reversebias/anaphase/README.md

# anaphase wireless split keyboard

anaphase is a Bluetooth/USB split ergonomic keyboard with a 3D printed case and custom PCB base.
