reversebias/anaphase/hardware/schematic.pdf

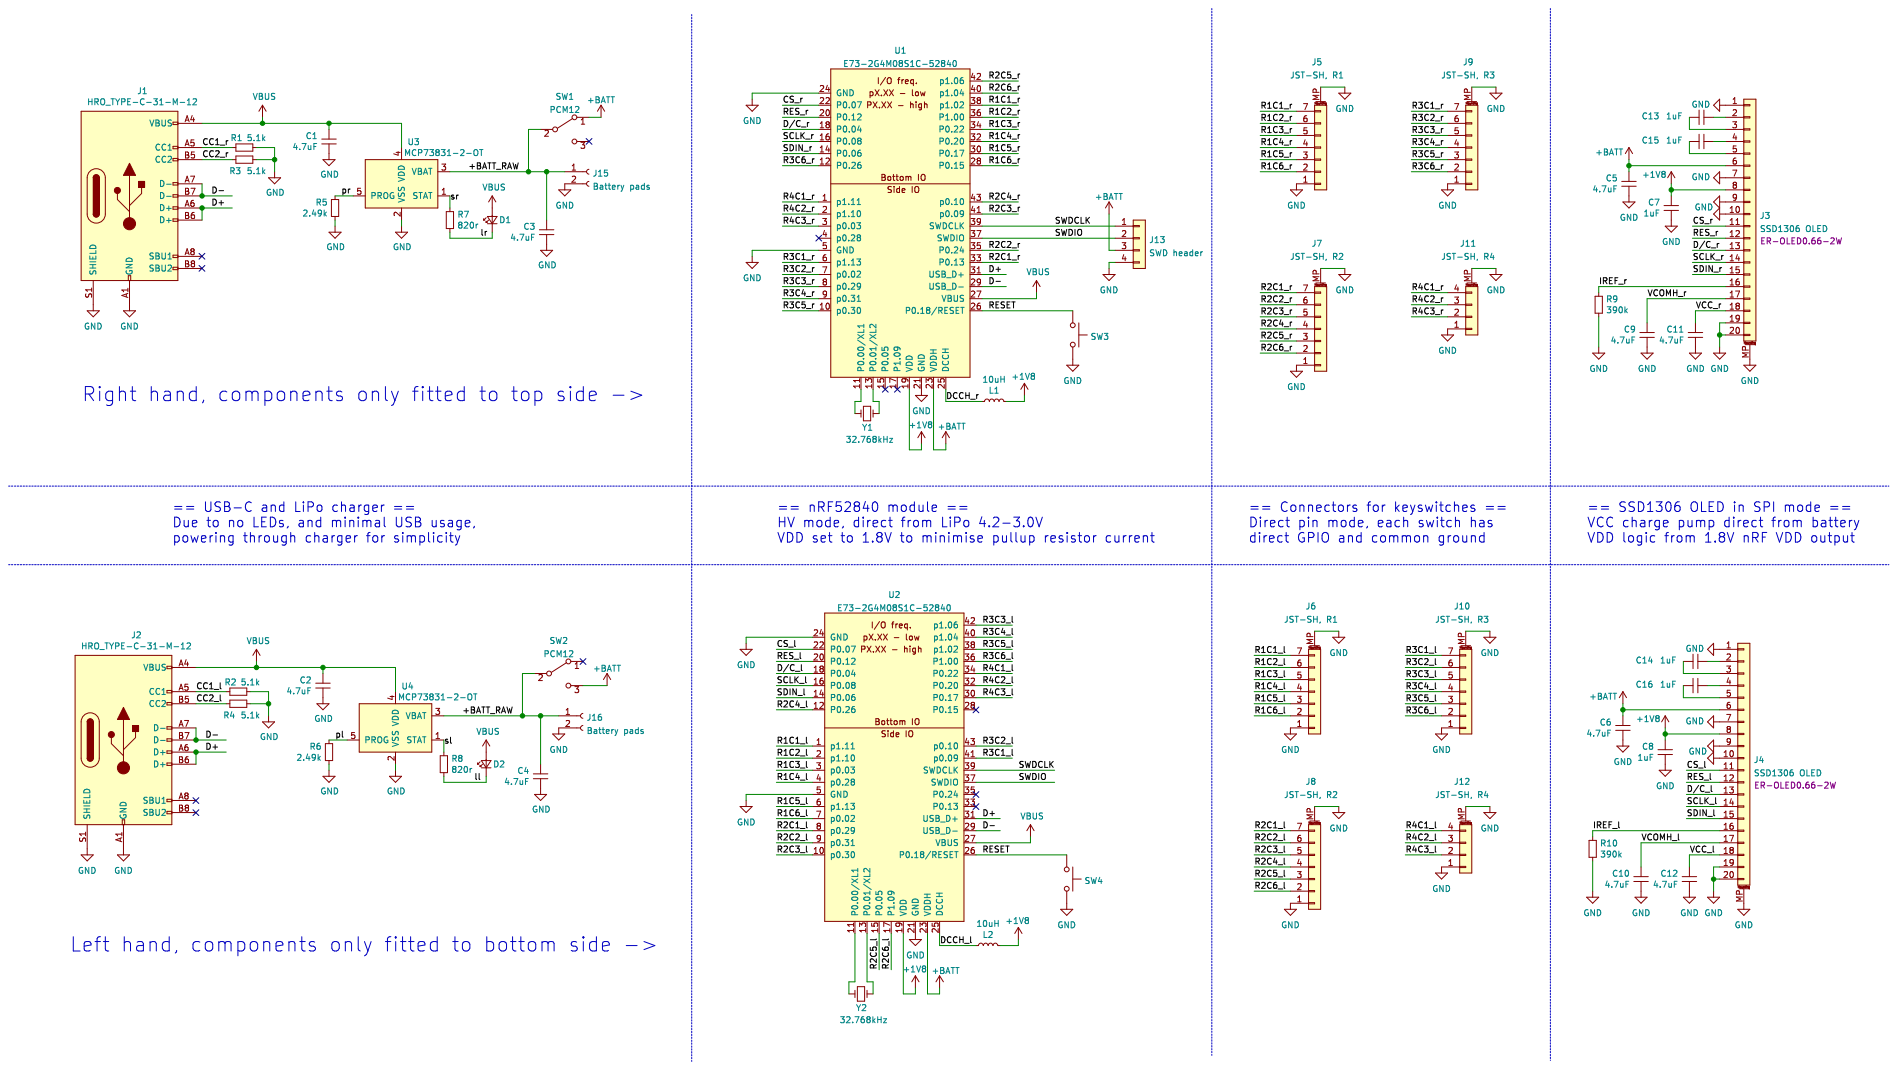
[picture p1: page 1]
