reversebias/anaphase/hardware/kicad_5.99/anaphase.kicad_pcb

## KiCad design hardware/kicad_5.99/anaphase.kicad_pcb (2021-11-22)

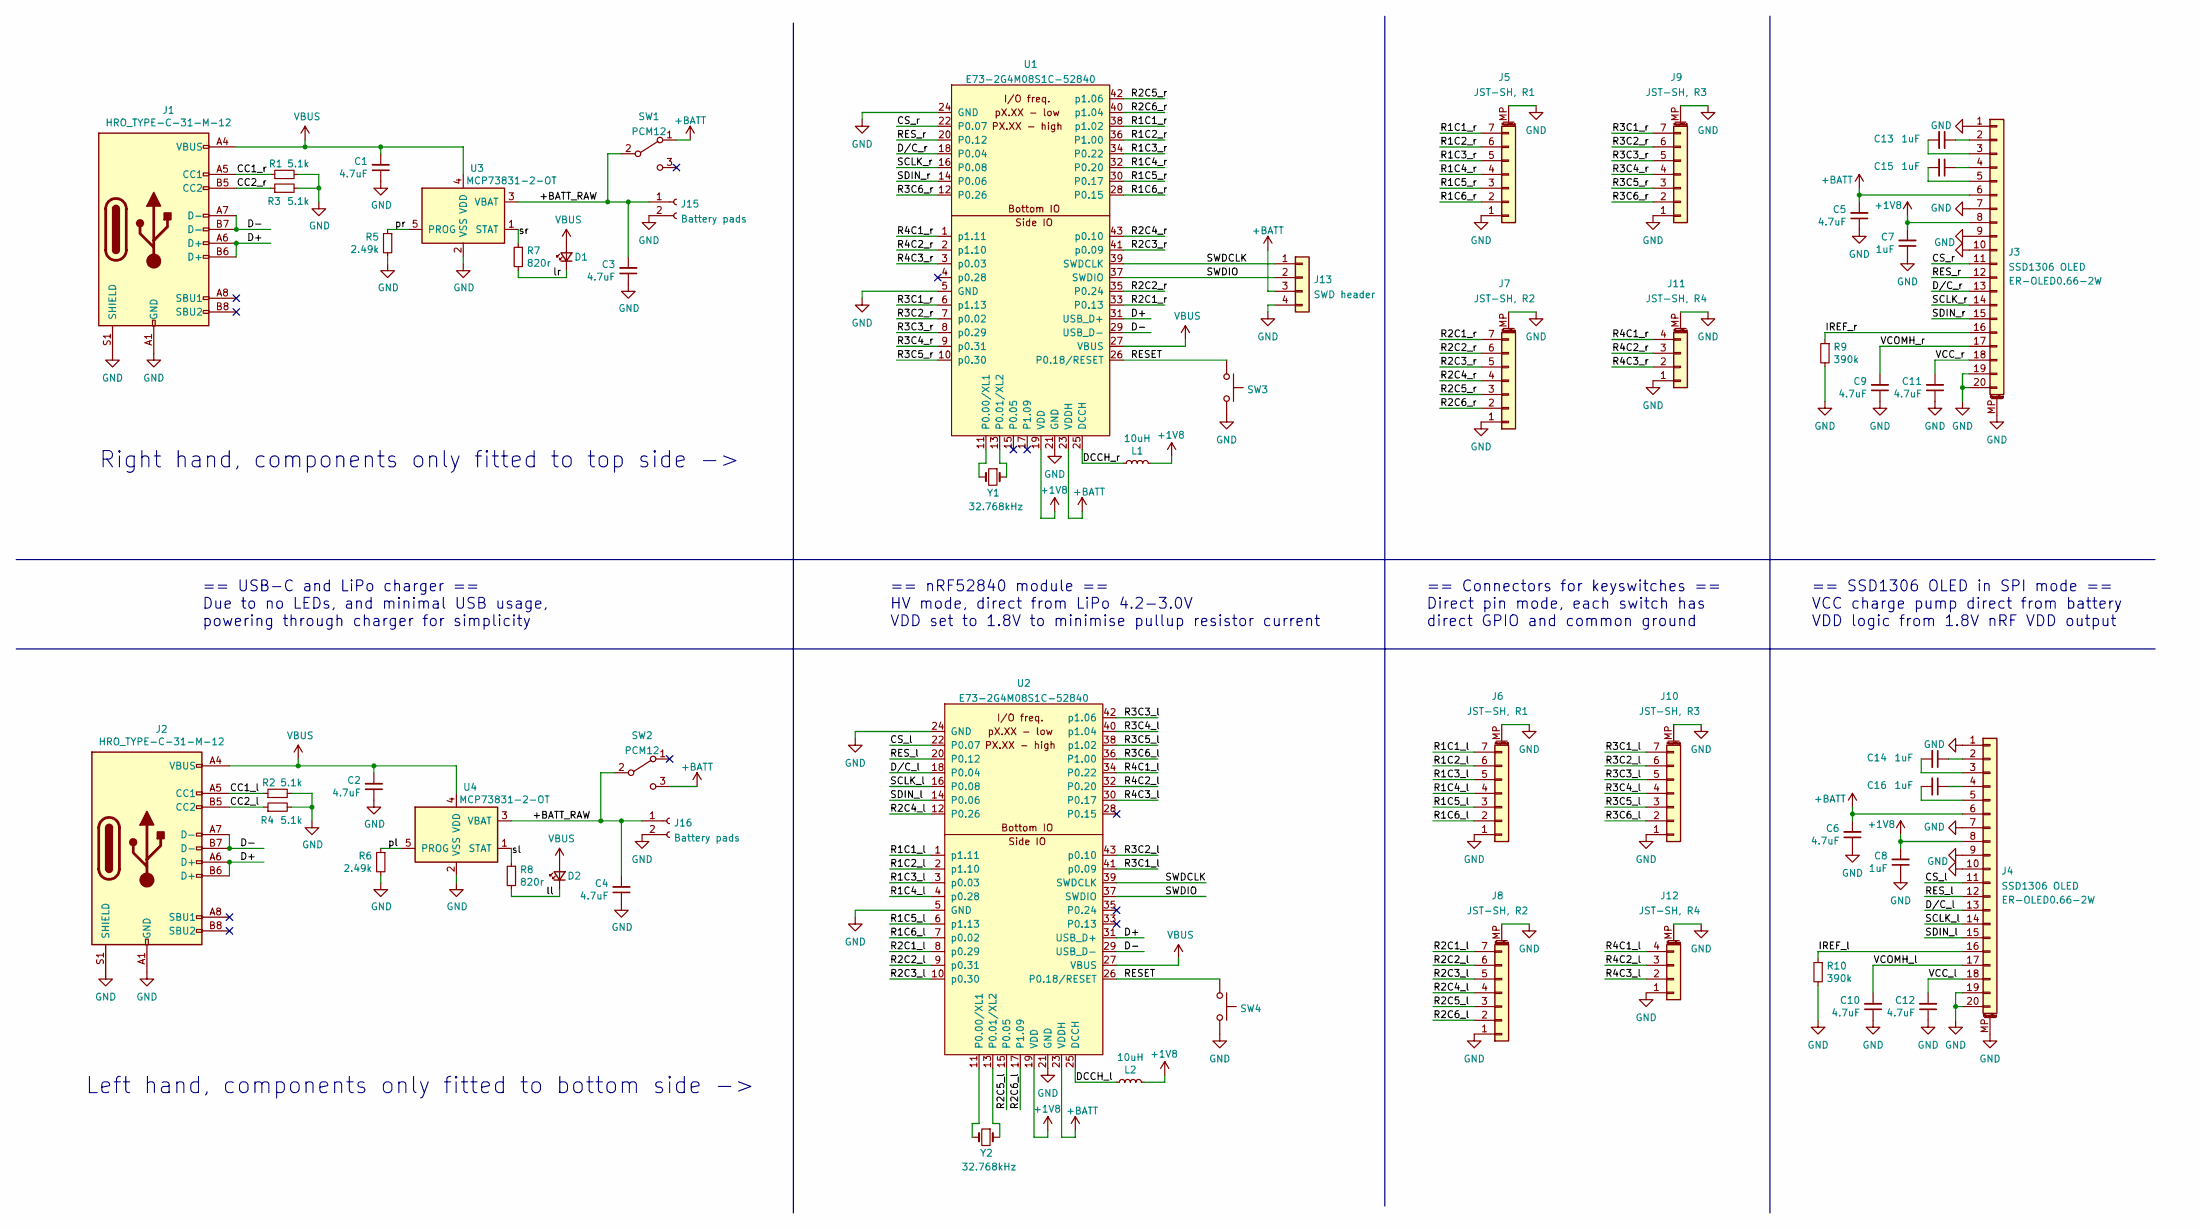
[picture p2: schematic anaphase.kicad_sch]

Parts:
C1, C2, C3, C4, C5, C6, C9, C10, C11, C12: 4.7uF; C_0603_1608Metric_Pad1.08x0.95mm_HandSolder
C7, C8, C13, C14, C15, C16: 1uF; C_0603_1608Metric_Pad1.08x0.95mm_HandSolder
D1, D2: AMBER; LED_0603_1608Metric
J1, J2: HRO_TYPE-C-31-M-12; USB_C_Receptacle_HRO_TYPE-C-31-M-12
J3, J4: SSD1306 OLED; Molex_5052782033
J5, J6: JST-SH, R1; JST_SH_BM07B-SRSS-TB_1x07-1MP_P1.00mm_Vertical
J7, J8: JST-SH, R2; JST_SH_BM07B-SRSS-TB_1x07-1MP_P1.00mm_Vertical
J9, J10: JST-SH, R3; JST_SH_BM07B-SRSS-TB_1x07-1MP_P1.00mm_Vertical
J11, J12: JST-SH, R4; JST_SH_BM04B-SRSS-TB_1x04-1MP_P1.00mm_Vertical
J13: SWD header; PinHeader_1x04_P2.54mm_Vertical
J15, J16: Battery pads; L_1210_3225Metric
L1, L2: 10uH; L_0603_1608Metric_Pad1.05x0.95mm_HandSolder
R1, R2, R3, R4: 5.1k; R_0603_1608Metric_Pad0.98x0.95mm_HandSolder
R5, R6: 2.49k; R_0603_1608Metric_Pad0.98x0.95mm_HandSolder
R7, R8: 820r; R_0603_1608Metric_Pad0.98x0.95mm_HandSolder
R9, R10: 390k; R_0603_1608Metric_Pad0.98x0.95mm_HandSolder
SW1, SW2: PCM12; SW_SPDT_PCM12
SW3, SW4: SW_Push; SW_Push_SPST_NO_Alps_SKRK
U1, U2: E73-2G4M08S1C-52840
U3, U4: MCP73831-2-OT; SOT-23-5
Y1, Y2: 32.768kHz; Crystal_SMD_MicroCrystal_CM9V-T1A-2Pin_1.6x1.0mm

Connections:
+1V8: C7.2, C8.2, J3.8, J4.8, L1.2, L2.2, U1.19 (VDD), U2.19 (VDD)
+BATT: C5.2, C6.2, J3.6, J4.6, J13.3, SW1.1 (A), SW2.3 (C), U1.23 (VDDH), U2.23 (VDDH)
/+BATT_RAW: C3.2, C4.2, J15.1, J16.1, SW1.2 (B), SW2.2 (B), U3.3 (VBAT), U4.3 (VBAT)
/CC1_l: J2.A5 (CC1), R2.1
/CC1_r: J1.A5 (CC1), R1.1
/CC2_l: J2.B5 (CC2), R4.1
/CC2_r: J1.B5 (CC2), R3.1
/CS_l: J4.11, U2.22 (P0.07)
/CS_r: J3.11, U1.22 (P0.07)
/D+: J1.A6 (D+), J1.B6 (D+), J2.A6 (D+), J2.B6 (D+), U1.31 (USB_D+), U2.31 (USB_D+)
/D-: J1.A7 (D-), J1.B7 (D-), J2.A7 (D-), J2.B7 (D-), U1.29 (USB_D-), U2.29 (USB_D-)
/DCCH_l: L2.1, U2.25 (DCCH)
/DCCH_r: L1.1, U1.25 (DCCH)
/D/C_l: J4.13, U2.18 (P0.04)
/D/C_r: J3.13, U1.18 (P0.04)
/IREF_l: J4.16, R10.1
/IREF_r: J3.16, R9.1
/R1C1_l: J6.7, U2.1 (p1.11)
/R1C1_r: J5.7, U1.38 (p1.02)
/R1C2_l: J6.6, U2.2 (p1.10)
/R1C2_r: J5.6, U1.36 (P1.00)
/R1C3_l: J6.5, U2.3 (p0.03)
/R1C3_r: J5.5, U1.34 (P0.22)
/R1C4_l: J6.4, U2.4 (p0.28)
/R1C4_r: J5.4, U1.32 (P0.20)
/R1C5_l: J6.3, U2.6 (p1.13)
/R1C5_r: J5.3, U1.30 (P0.17)
/R1C6_l: J6.2, U2.7 (p0.02)
/R1C6_r: J5.2, U1.28 (P0.15)
/R2C1_l: J8.7, U2.8 (p0.29)
/R2C1_r: J7.7, U1.33 (P0.13)
/R2C2_l: J8.6, U2.9 (p0.31)
/R2C2_r: J7.6, U1.35 (P0.24)
/R2C3_l: J8.5, U2.10 (p0.30)
/R2C3_r: J7.5, U1.41 (p0.09)
/R2C4_l: J8.4, U2.12 (P0.26)
/R2C4_r: J7.4, U1.43 (p0.10)
/R2C5_l: J8.3, U2.15 (P0.05)
/R2C5_r: J7.3, U1.42 (p1.06)
/R2C6_l: J8.2, U2.17 (P1.09)
/R2C6_r: J7.2, U1.40 (p1.04)
/R3C1_l: J10.7, U2.41 (p0.09)
/R3C1_r: J9.7, U1.6 (p1.13)
/R3C2_l: J10.6, U2.43 (p0.10)
/R3C2_r: J9.6, U1.7 (p0.02)
/R3C3_l: J10.5, U2.42 (p1.06)
/R3C3_r: J9.5, U1.8 (p0.29)
/R3C4_l: J10.4, U2.40 (p1.04)
/R3C4_r: J9.4, U1.9 (p0.31)
/R3C5_l: J10.3, U2.38 (p1.02)
/R3C5_r: J9.3, U1.10 (p0.30)
/R3C6_l: J10.2, U2.36 (P1.00)
/R3C6_r: J9.2, U1.12 (P0.26)
/R4C1_l: J12.4, U2.34 (P0.22)
/R4C1_r: J11.4, U1.1 (p1.11)
/R4C2_l: J12.3, U2.32 (P0.20)
/R4C2_r: J11.3, U1.2 (p1.10)
/R4C3_l: J12.2, U2.30 (P0.17)
/R4C3_r: J11.2, U1.3 (p0.03)
/RESET: SW3.1, SW4.1, U1.26 (P0.18/RESET), U2.26 (P0.18/RESET)
/RES_l: J4.12, U2.20 (P0.12)
/RES_r: J3.12, U1.20 (P0.12)
/SCLK_l: J4.14, U2.16 (P0.08)
/SCLK_r: J3.14, U1.16 (P0.08)
/SDIN_l: J4.15, U2.14 (P0.06)
/SDIN_r: J3.15, U1.14 (P0.06)
/SWDCLK: J13.1, U1.39 (SWDCLK), U2.39 (SWDCLK)
/SWDIO: J13.2, U1.37 (SWDIO), U2.37 (SWDIO)
/VCC_l: C12.2, J4.18
/VCC_r: C11.2, J3.18
/VCOMH_l: C10.2, J4.17
/VCOMH_r: C9.2, J3.17
/ll: D2.1 (K), R8.2
/lr: D1.1 (K), R7.2
/pl: R6.1, U4.5 (PROG)
/pr: R5.1, U3.5 (PROG)
/sl: R8.1, U4.1 (STAT)
/sr: R7.1, U3.1 (STAT)
GND: C1.1, C2.1, C3.1, C4.1, C5.1, C6.1, C7.1, C8.1, C9.1, C10.1, C11.1, C12.1, J1.A1 (GND), J1.A12 (GND), J1.B1 (GND), J1.B12 (GND), J1.S1 (SHIELD), J2.A1 (GND), J2.A12 (GND), J2.B1 (GND), J2.B12 (GND), J2.S1 (SHIELD), J3.1, J3.7, J3.9, J3.10, J3.19, J3.20, J3.MP (MountPin), J4.1, J4.7, J4.9, J4.10, J4.19, J4.20, J4.MP (MountPin), J5.1, J5.MP (MountPin), J6.1, J6.MP (MountPin), J7.1, J7.MP (MountPin), J8.1, J8.MP (MountPin), J9.1, J9.MP (MountPin), J10.1, J10.MP (MountPin), J11.1, J11.MP (MountPin), J12.1, J12.MP (MountPin), J13.4, J15.2, J16.2, R1.2, R2.2, R3.2, R4.2, R5.2, R6.2, R9.2, R10.2, SW3.2, SW4.2, U1.5 (GND), U1.21 (GND), U1.24 (GND), U2.5 (GND), U2.21 (GND), U2.24 (GND), U3.2 (VSS), U4.2 (VSS)
unnamed: C13.1, J3.2
unnamed: C13.2, J3.3
unnamed: C14.1, J4.2
unnamed: C14.2, J4.3
unnamed: C15.1, J3.4
unnamed: C15.2, J3.5
unnamed: C16.1, J4.4
unnamed: C16.2, J4.5
unnamed: U1.11 (P0.00/XL1), Y1.2
unnamed: U1.13 (P0.01/XL2), Y1.1
unnamed: U2.11 (P0.00/XL1), Y2.2
unnamed: U2.13 (P0.01/XL2), Y2.1
VBUS: C1.2, C2.2, D1.2 (A), D2.2 (A), J1.A4 (VBUS), J1.A9 (VBUS), J1.B4 (VBUS), J1.B9 (VBUS), J2.A4 (VBUS), J2.A9 (VBUS), J2.B4 (VBUS), J2.B9 (VBUS), U1.27 (VBUS), U2.27 (VBUS), U3.4 (VDD), U4.4 (VDD)

Notes on the sheet:
Left hand, components only fitted to bottom side ->
Right hand, components only fitted to top side ->
== USB-C and LiPo charger == Due to no LEDs, and minimal USB usage, powering through charger for simplicity
== nRF52840 module == HV mode, direct from LiPo 4.2-3.0V VDD set to 1.8V to minimise pullup resistor current
== Connectors for keyswitches == Direct pin mode, each switch has direct GPIO and common ground
== SSD1306 OLED in SPI mode == VCC charge pump direct from battery VDD logic from 1.8V nRF VDD output

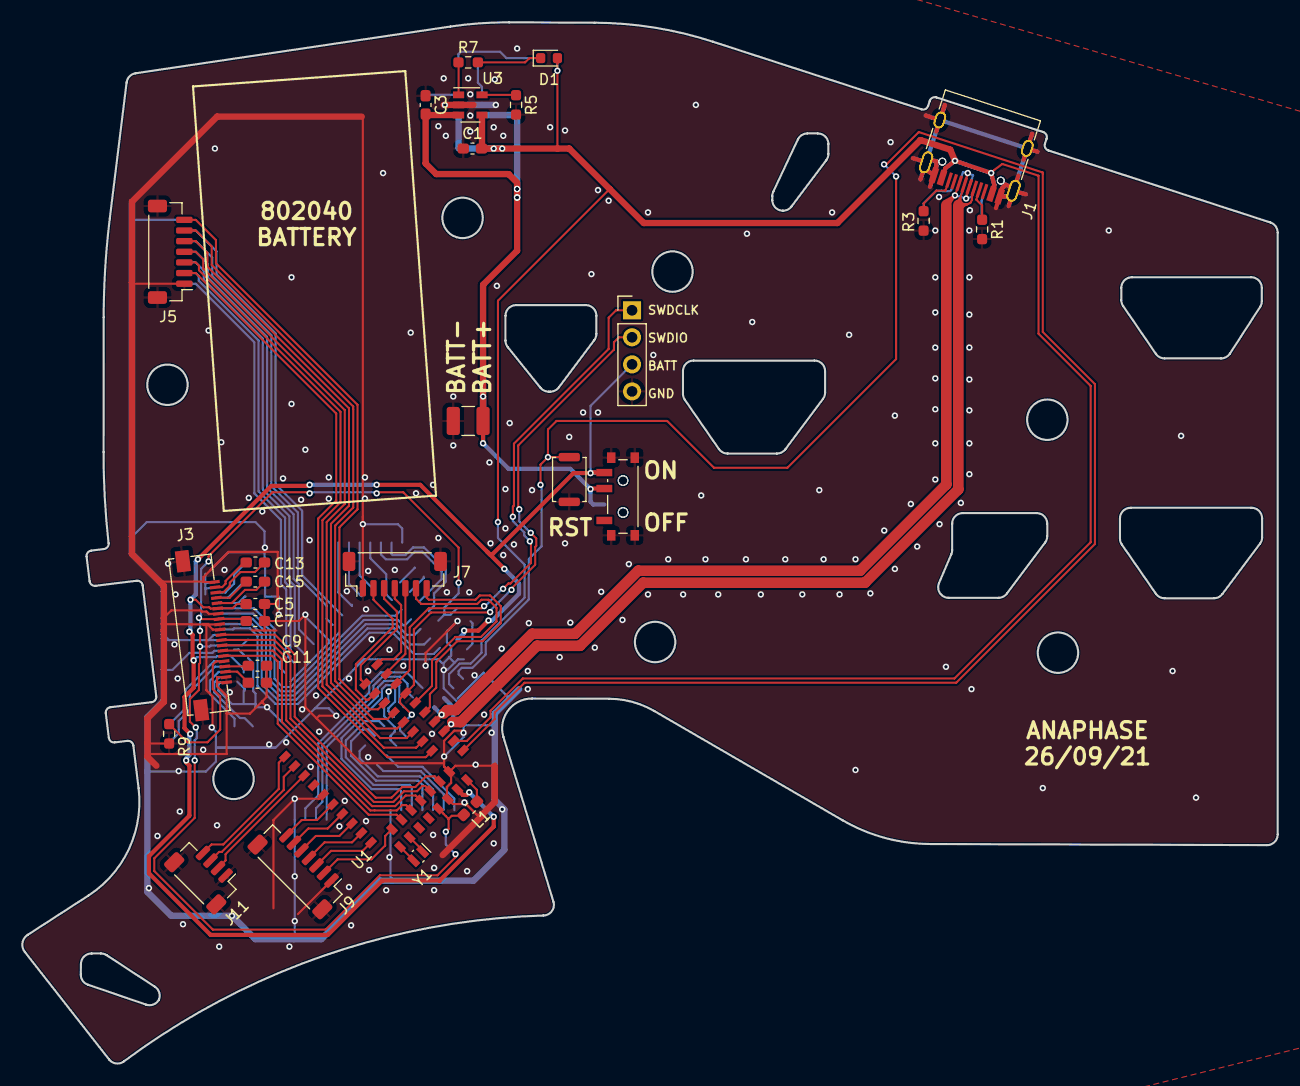
[picture p3: board anaphase.kicad_pcb from above]

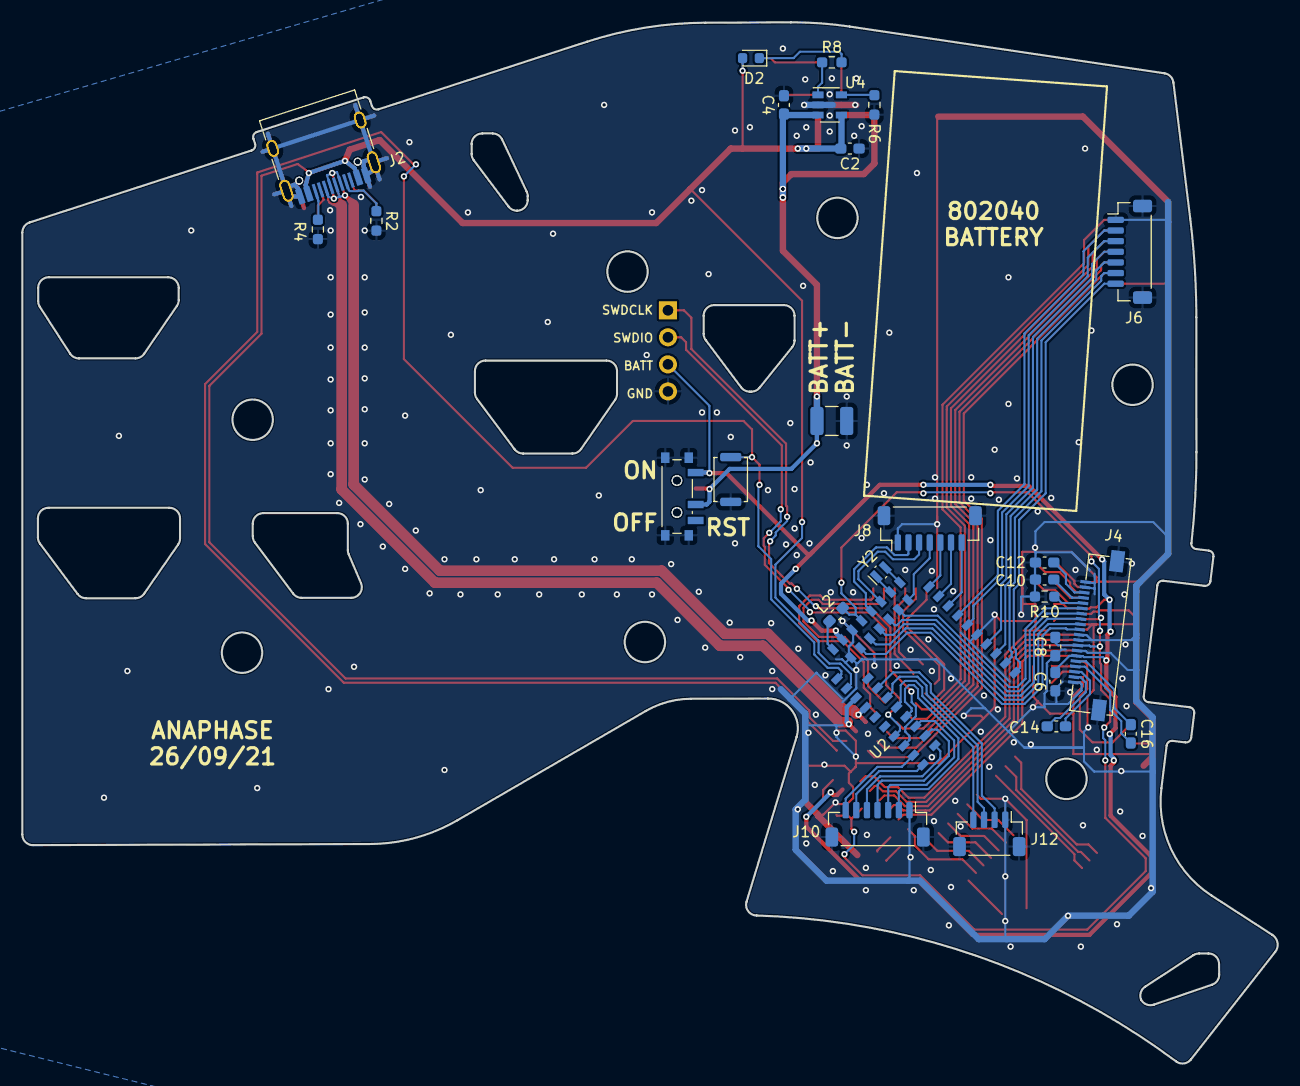
[picture p4: board anaphase.kicad_pcb from below]

Board: 2 copper layers, 118.0 x 97.8 mm, 55 parts (27 on the bottom side), 92 nets.
