reversebias/anaphase/(commit log)

2021-11-16 Uploading hardware design files
    [anaphase-B_Cu.gbl, anaphase-B_Mask.gbs, anaphase-B_Paste.gbp, anaphase-B_Silkscreen.gbo, anaphase-Edge_Cuts.gm1, anaphase-F_Cu.gtl, anaphase-F_Mask.gts, anaphase-F_Paste.gtp]
2022-01-13 mutex problem with battery level
2022-01-13 maybe solved mutex on battery
2022-01-15 layer and battery status, no live updates for battery
